JorgeDeLosRazo/Business-Card-PCB/README.md

# Business Card PCB
This repo includes the KiCad files for a PCB I designed that will function as a business card. The hardware on top of the PCB will allow the user
to play a simple "Simon Says" style of game, where LEDs will display a pattern of lights that the user will have to replicate by pressing three tactile buttons.

## KiCad
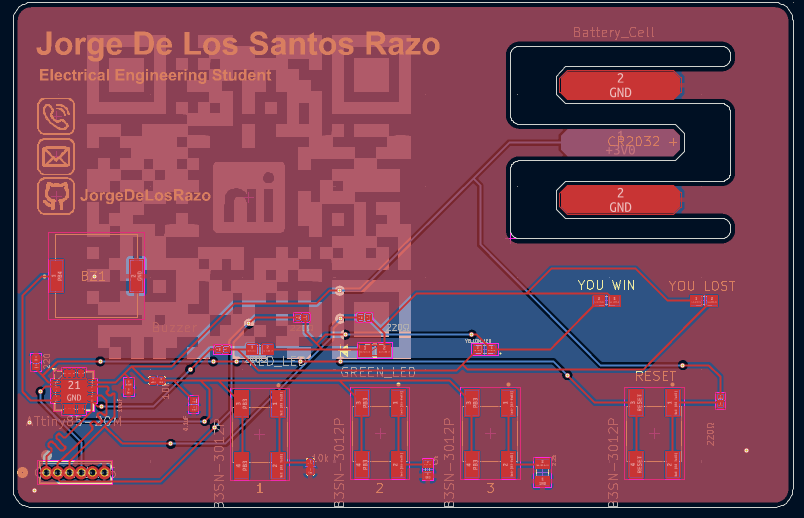
[picture p1: Custom Graphics/kicad-pcb-screenshot.png]


## Components

| Component | Qty. |
|---|---|
| ATtiny85 | 1 | 
| Tactile Buttons | 4 |
| Piezo Buzzer | 1 |
| Red LED | 3 |
| Yellow LEDs | 1 |
| Green LED | 1 |
