JorgeDeLosRazo/Business-Card-PCB/Custom Graphics/email_custom.png

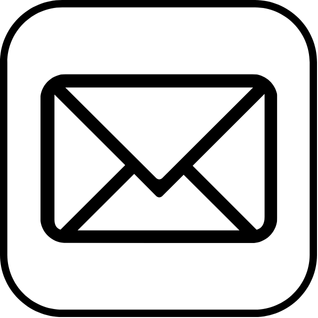
Custom Graphics/email_custom.png
