JorgeDeLosRazo/Business-Card-PCB/Custom Graphics/github_custom.png

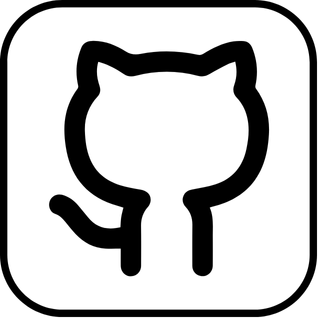
Custom Graphics/github_custom.png
