JorgeDeLosRazo/Business-Card-PCB/Custom Graphics/KiCad-Screenshot.png

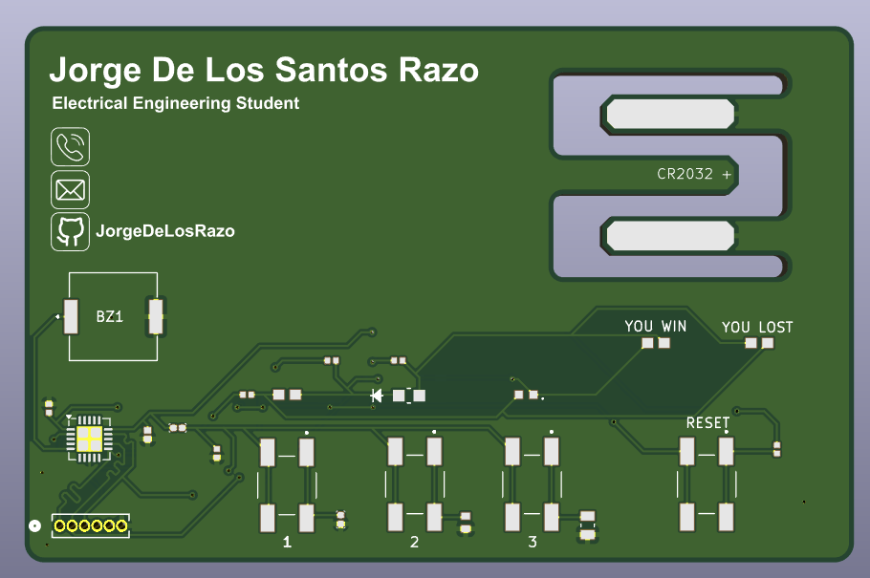
Custom Graphics/KiCad-Screenshot.png
