JorgeDeLosRazo/Business-Card-PCB/Custom Graphics/linkedin_custom.png

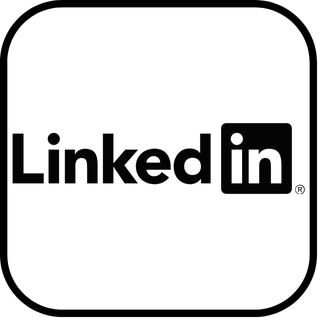
Custom Graphics/linkedin_custom.png
