JorgeDeLosRazo/Business-Card-PCB/Custom Graphics/phone.png

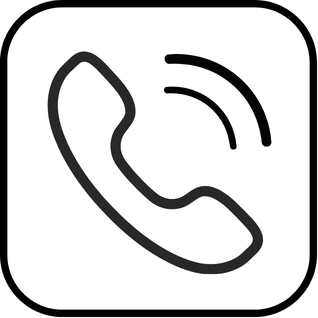
Custom Graphics/phone.png
