JorgeDeLosRazo/Business-Card-PCB/Business_Card.kicad_pcb

## KiCad design Business_Card.kicad_pcb (2026-02-17)

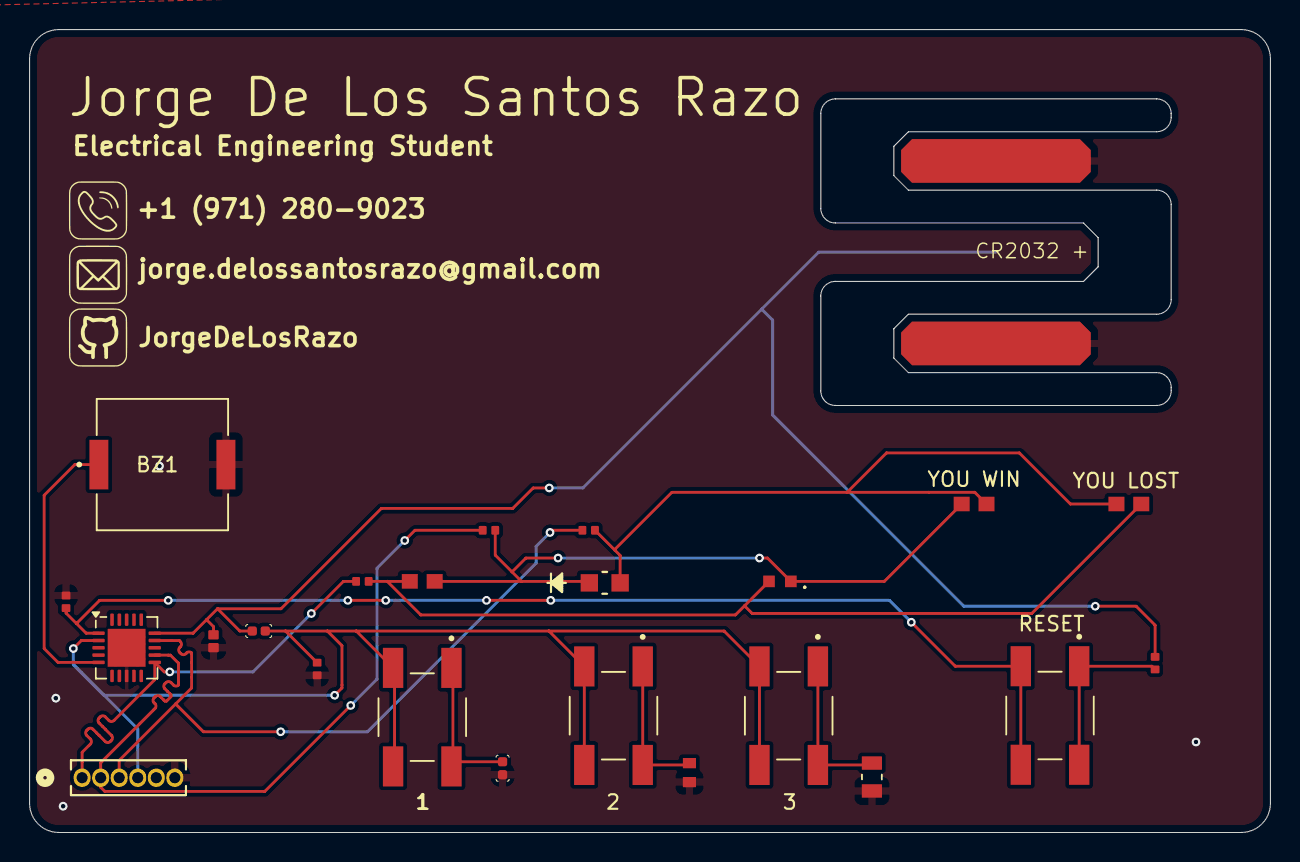
[picture p7: board Business_Card.kicad_pcb from above]

Board: 2 copper layers, 85.0 x 55.0 mm, 24 parts (0 on the bottom side), 15 nets.

Parts:
1, 2, 3: B3SN-3012P; SW_B3SN-3012P
BT1: Battery_Cell; Coin_Battery_Holder_CR2032
BZ1: Buzzer; piezo_buzzer
C1: 10uF; C_106
C2: 0.1uF; C_104
J2: Conn_01x06; conn_01x06
LED1: RED_LED; SMD_RED_LTST-S270KRKT
LED2: GREEN_LED; SMD__GREEN_LTST-C170GKT_LTO
LED3: YELLOW_LED; YELLOW_LED_.LTST-C190KSKT
LED4: WON_LED; SMD_RED_LTST-S270KRKT
LED5: LOST_LED; SMD_RED_LTST-S270KRKT
R1, R2, R3, R8: 220Ω; 221_R_RESC1005X40N
R4, R5: 10k; R_0103
R6: 4.7k; R_0472
R7: 2.2k; R_0222
R9: 220; 221_R_RESC1005X40N
RESET: B3SN-3012P; SW_B3SN-3012P
U1: ATtiny85-20M; QFN-20-1EP_4x4mm_P0.5mm_EP2.6x2.6mm

Connections:
+3V0: BT1.1 (+), C1.1, R4.1, R8.1, U1.15 (VCC)
/PB0: J2.1, R1.1, U1.11 (AREF/PB0)
/PB1: J2.2, R2.1, U1.12 (PB1)
/PB2: J2.3, R3.1, U1.14 (PB2)
/PB3: 1.3, 1.4, 2.3, 2.4, 3.3, 3.4, C2.1, J2.4, R4.2, U1.2 (XTAL1/PB3)
/PB4: BZ1.1 (+), U1.5 (XTAL2/PB4)
/RESET: R9.1, RESET.3, RESET.4, U1.1 (~RESET/PB5)
GND: BT1.2 (-), BZ1.2 (-), C1.2, C2.2, J2.6, R5.1, R6.1, R7.1, R9.2, U1.8 (GND), U1.21 (GND)
unnamed: LED1.2 (A), LED2.1 (K), LED3.1 (K), LED4.2 (A), R2.2
unnamed: LED1.1 (K), LED3.2 (A), LED5.2 (A), R1.2
unnamed: LED2.2 (A), LED4.1 (K), LED5.1 (K), R3.2
unnamed: 1.1, 1.2, R5.2
unnamed: 2.1, 2.2, R6.2
unnamed: 3.1, 3.2, R7.2
unnamed: R8.2, RESET.1, RESET.2
