JorgeDeLosRazo/Business-Card-PCB/(commit log)

2025-09-25 updated schematic
    [Business_Card.kicad_pcb, Business_Card.kicad_sch]
2025-09-25 nothing new
    [Business_Card.kicad_sch]
2025-09-28 added code for buttons
2025-10-28 updated schemaatics
    [Business_Card.kicad_sch]
2025-11-25 extra stuff
    [Business_Card.kicad_pcb]
2025-12-29 Finished PCB
    [Business_Card.kicad_pcb, Business_Card.kicad_sch]
2025-12-31 cleared all the DRC errors
    [Business_Card.kicad_pcb]
2026-02-17 created symbol folder
    [Business_Card.kicad_pcb, bom.csv, designators.csv, positions.csv]
